airpocket-soundman/acrylic_pan_uno_q/docs/assets/hackster/acrylic-pan-12-hit-vibration-modes.gif

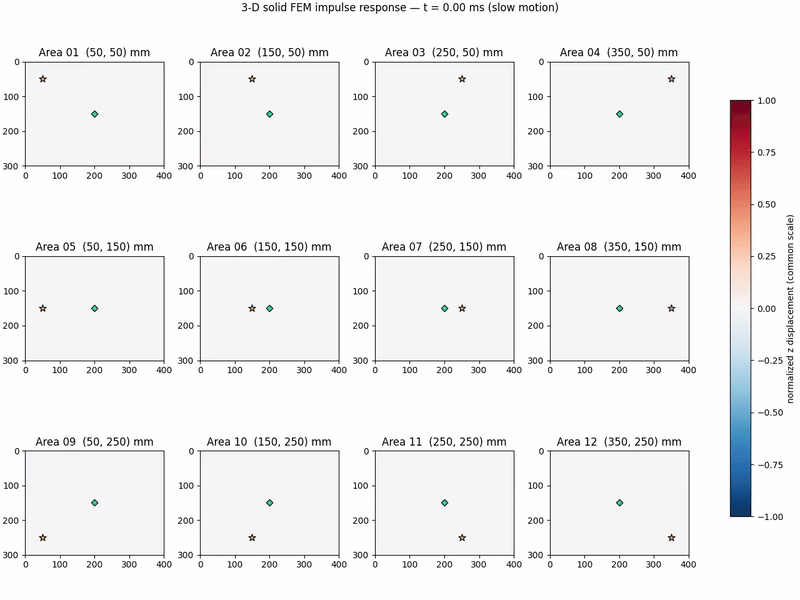
docs/assets/hackster/acrylic-pan-12-hit-vibration-modes.gif
