airpocket-soundman/acrylic_pan_uno_q/docs/assets/hackster/modal-touch-cover.png

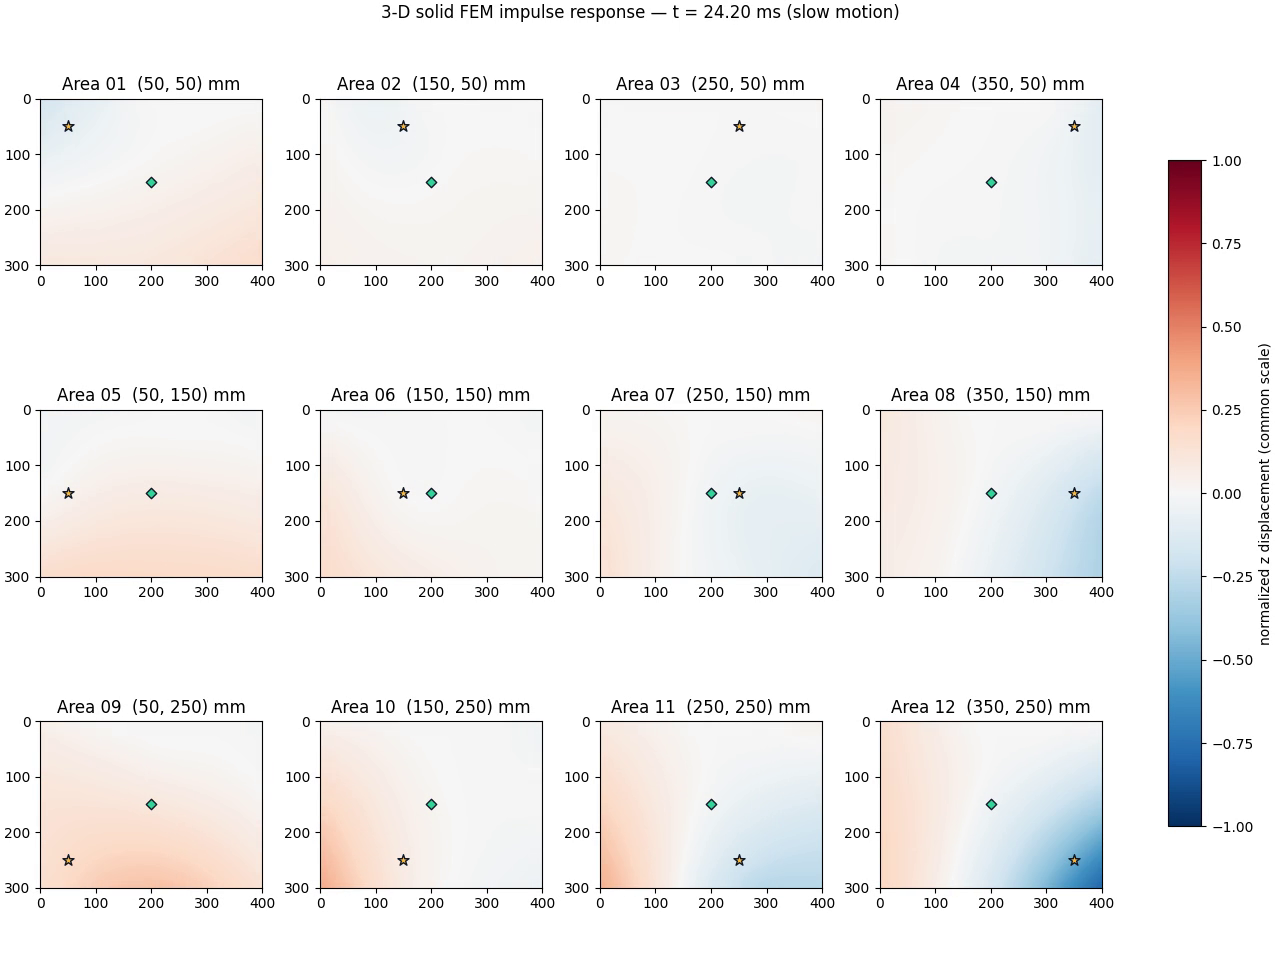
docs/assets/hackster/modal-touch-cover.png
