airpocket-soundman/acrylic_pan_uno_q/docs/assets/hackster/panel-layout.png

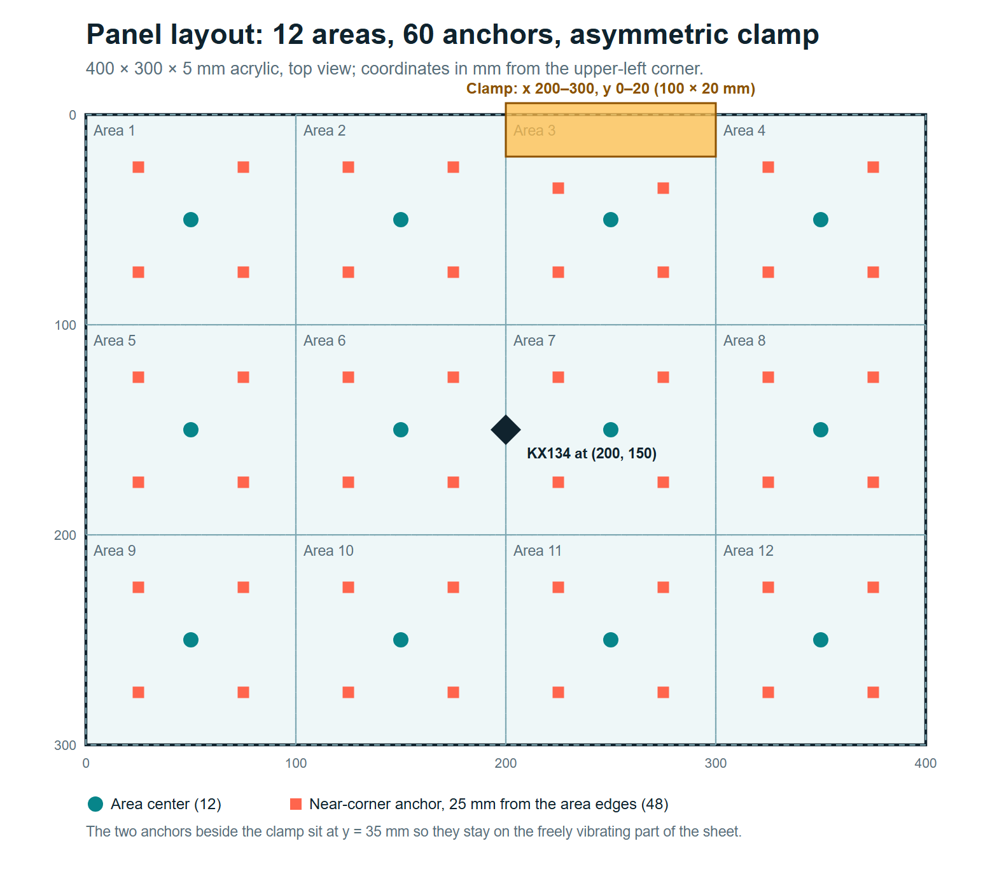
docs/assets/hackster/panel-layout.png
