airpocket-soundman/acrylic_pan_uno_q/docs/assets/hackster/pc-xy-regression-comparison.png

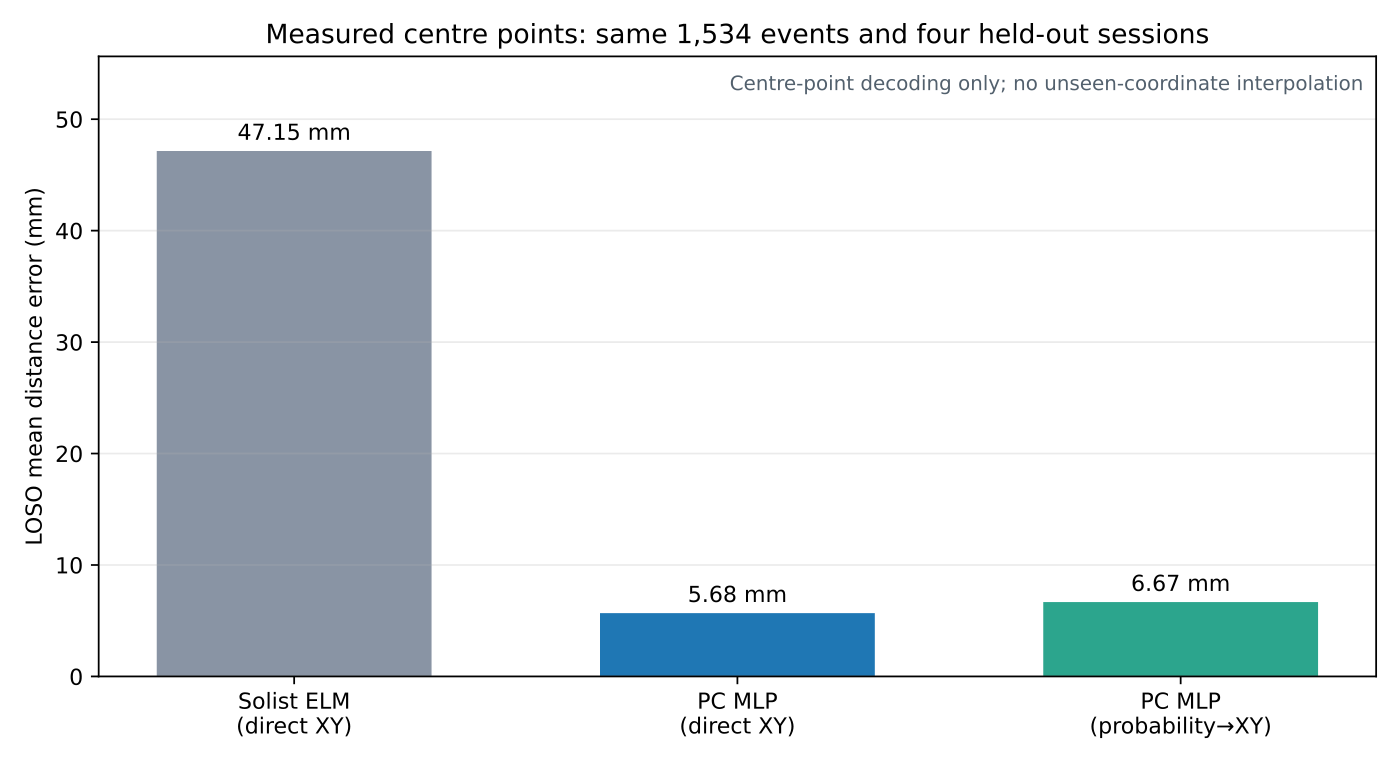
docs/assets/hackster/pc-xy-regression-comparison.png
