airpocket-soundman/acrylic_pan_uno_q/docs/assets/hackster/probability-instrument-ui.png

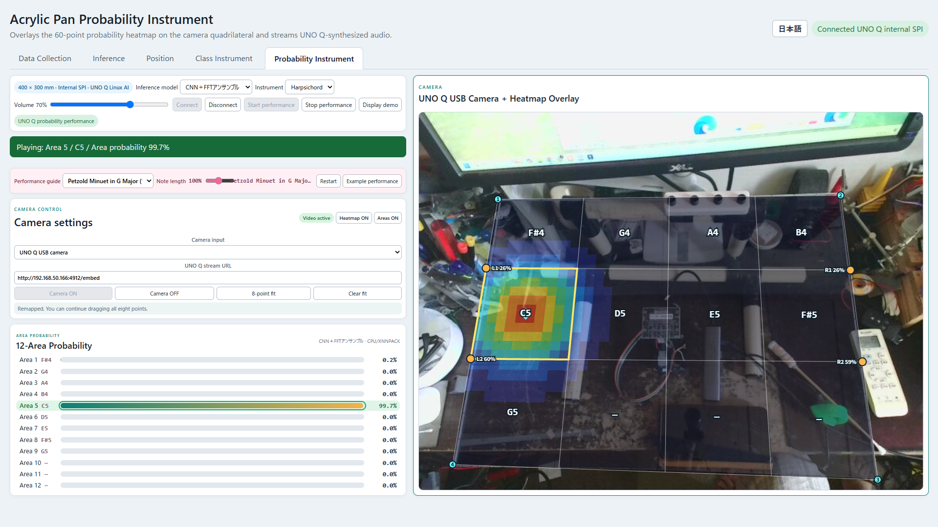
docs/assets/hackster/probability-instrument-ui.png
