airpocket-soundman/acrylic_pan_uno_q/docs/assets/hackster/uno-q-low-latency-flow.png

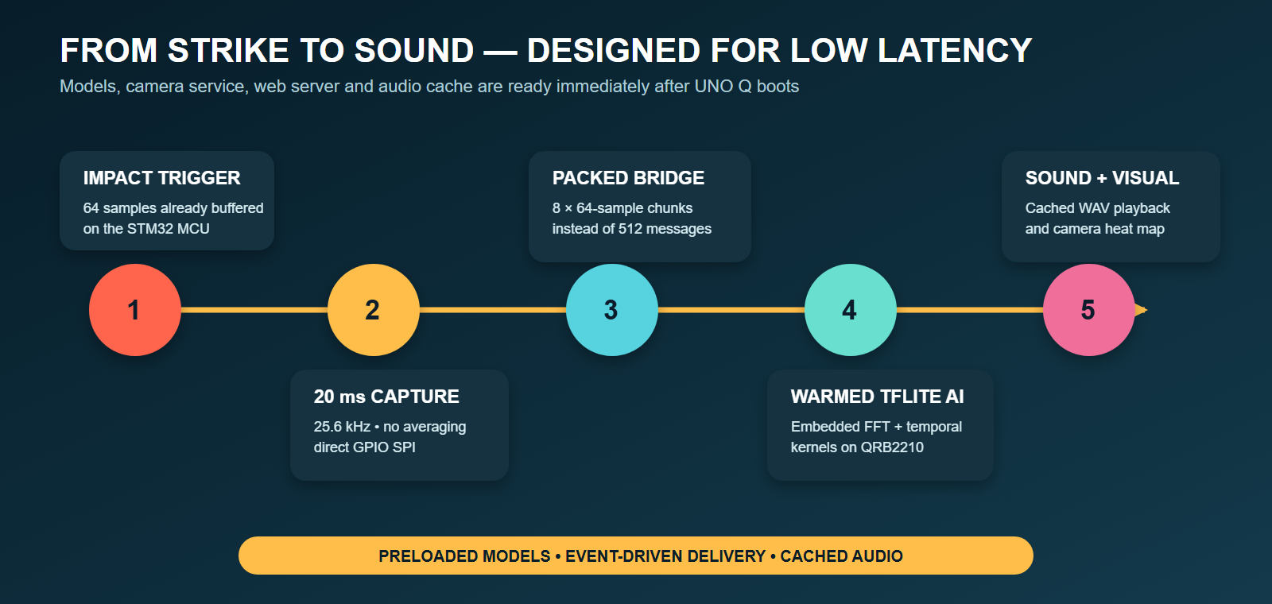
docs/assets/hackster/uno-q-low-latency-flow.png
