airpocket-soundman/acrylic_pan_uno_q/docs/assets/hackster/web/arduino-uno-q.jpg

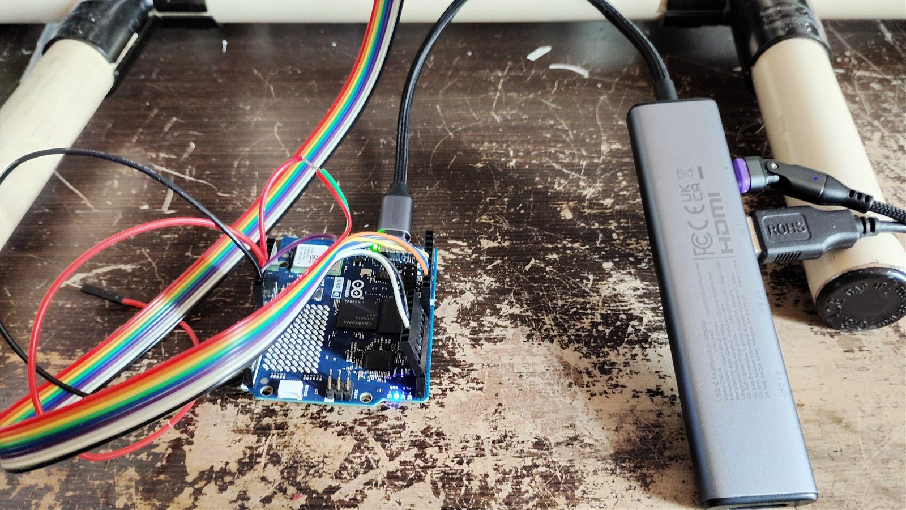
docs/assets/hackster/web/arduino-uno-q.jpg
