airpocket-soundman/acrylic_pan_uno_q/docs/assets/hackster/web/kx134-sensor-bottom.jpg

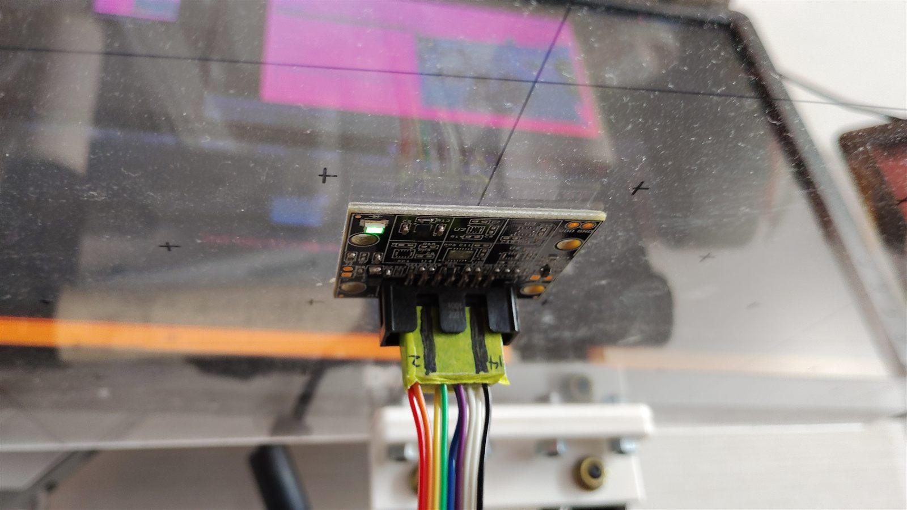
docs/assets/hackster/web/kx134-sensor-bottom.jpg
