airpocket-soundman/acrylic_pan_uno_q/docs/assets/hackster/web/kx134-sensor-top.jpg

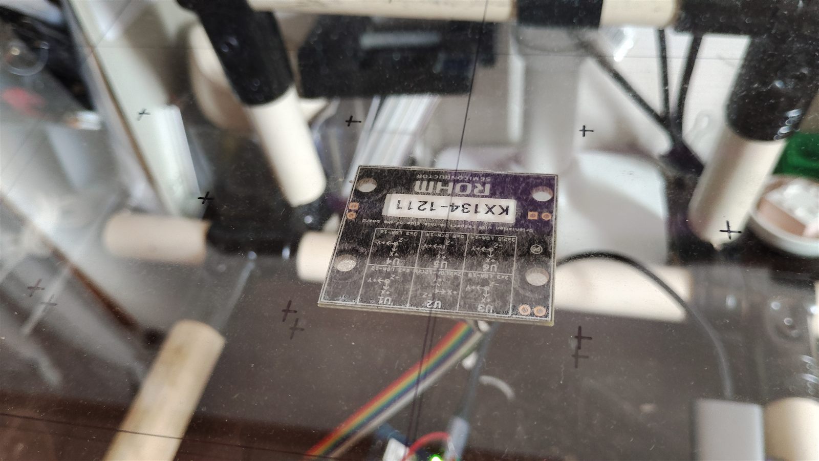
docs/assets/hackster/web/kx134-sensor-top.jpg
