airpocket-soundman/acrylic_pan_uno_q/docs/assets/hackster/web/mallet-overview.jpg

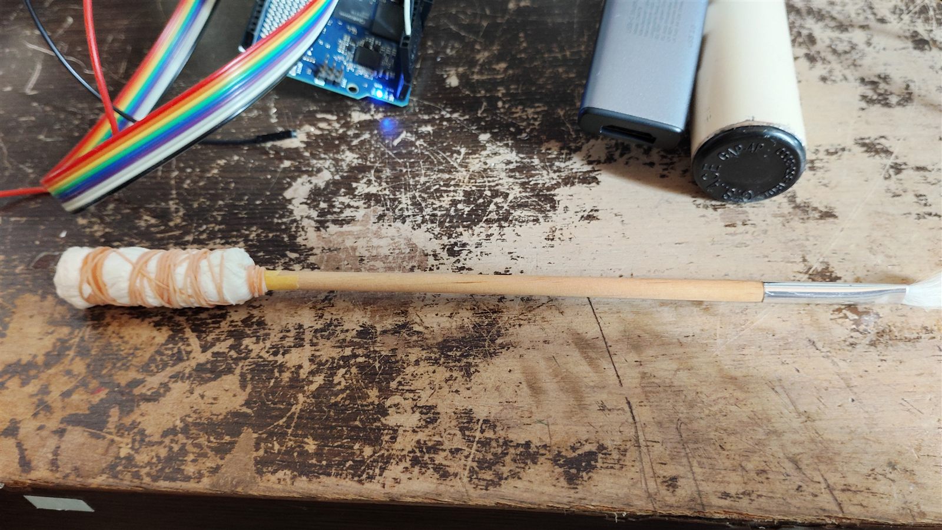
docs/assets/hackster/web/mallet-overview.jpg
