airpocket-soundman/acrylic_pan_uno_q/docs/assets/hackster/web/mallet-tip.jpg

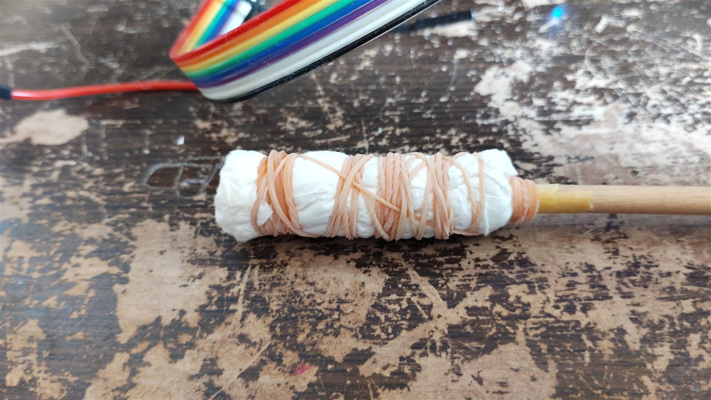
docs/assets/hackster/web/mallet-tip.jpg
