airpocket-soundman/acrylic_pan_uno_q/docs/assets/hackster/xy-training-layout.png

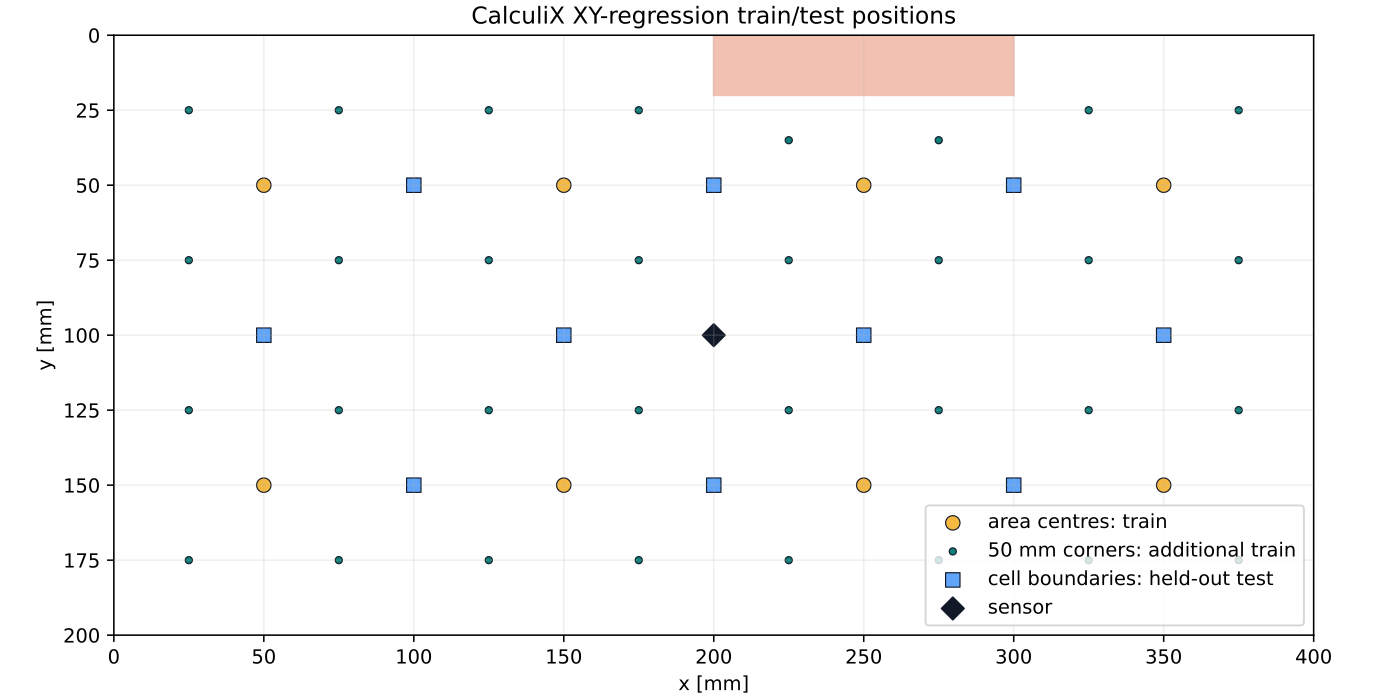
docs/assets/hackster/xy-training-layout.png
