airpocket-soundman/acrylic_pan_uno_q/docs/uno-q-bom.md

# Acrylic Pan UNO Q BOM

## 対象構成

- パネル: アクリル 400 × 300 × 5 mm
- 打点分類: 4列 × 3行、12クラス
- センサ: Solist AI用KX134-1211ブレークアウトボード × 1
- 推論・通信: Arduino UNO Q

## 本体構成品

| 区分 | 品目 | 数量 | 仕様・候補 | 状態 |
|---|---|---:|---|---|
| 演算 | Arduino UNO Q | 1 | Linux側AI・USBホスト＋MCU側SPI取得 | 使用中 |
| センサ | Solist AI用KX134-1211ブレークアウトボード | 1 | DT-EBML63Q2557キット由来の別体基板 | 既存品を流用 |
| センサケーブル | 2 × 7極 IDCメスケーブル | 1 | 2.54 mmピッチ、キー付き、既存品は約40 cm | 既存品を流用 |
| 変換コネクタ | 2 × 7極 キー付きボックスヘッダ | 1 | 参考: Würth Elektronik 61201421721、WR-BHD、ライトアングル | 調達前に嵌合・向きを実物確認 |
| 変換基板 | UNO Q–CN1 SPIアダプタ | 1 | CN1からD10–D13、D2/D3、3.3 V、GNDへ配線 | 設計・製作が必要 |
| 配線材 | ピンヘッダ／短配線 | 1式 | SPI配線は短くし、GNDを確実に共通化 | アダプタ構成に合わせて選定 |
| 打撃面 | 透明アクリル板 | 1 | 400 × 300 × 5 mm | 現行仕様 |
| センサ固定 | 硬質接着材または小型ねじ | 1式 | センサを(200, 150) mm付近へ剛結合 | 周波数応答を見て最終決定 |
| パネル固定 | クランプ／固定治具 | 1式 | FEMと実機で境界条件を一致させる | 機構設計に合わせて最終決定 |
| USBホスト | 外部給電対応USB-Cハブ | 1 | UNO Q公式カメラ構成、PD入力付き | 注文済み |
| カメラ | UVC USBカメラ | 1 | UNO Q Linux側で取得してWeb UIへ配信 | 接続試験待ち |
| ハブ電源 | 安定化5 V / 3 A電源 | 1 | USB-Cハブとカメラへの給電 | 準備が必要 |
| PC接続 | USB-Cデータケーブル | 1 | 給電・ADB・開発用。ホスト運転時はWi-Fi管理 | 使用中 |

## 開発・検査用（製品BOM外）

| 品目 | 用途 |
|---|---|
| デジタルマルチメータ | 導通、短絡、CN1-5/8の3.3 V確認 |
| ロジックアナライザまたはオシロスコープ | SPIクロック、CS、信号品質の確認（任意） |
| PC | Web UI、学習、評価、UNO Qへのデプロイ |

## 調達前の未確定事項

1. `61201421721`は形状の参照候補であり、既存IDCケーブルとのキー位置、ピン1方向、実装高さを実物で確認してから発注する。
2. 変換基板の外形、UNO Q側ヘッダ実装方式、ストレインリリーフは筐体設計後に確定する。
3. センサ固定材とパネル固定治具は、実測FRFと再現性評価の結果を部品選定へ反映する。
4. センサ基板は3.3 V専用として扱い、5 V部品や5 V信号は使用しない。

センサ接続は [`uno-q-sensor-wiring.md`](uno-q-sensor-wiring.md)、USBカメラと給電は
[`uno-q-usb-camera.md`](uno-q-usb-camera.md) を参照する。
