airpocket-soundman/acrylic_pan_uno_q/cad/bracket_b.stl

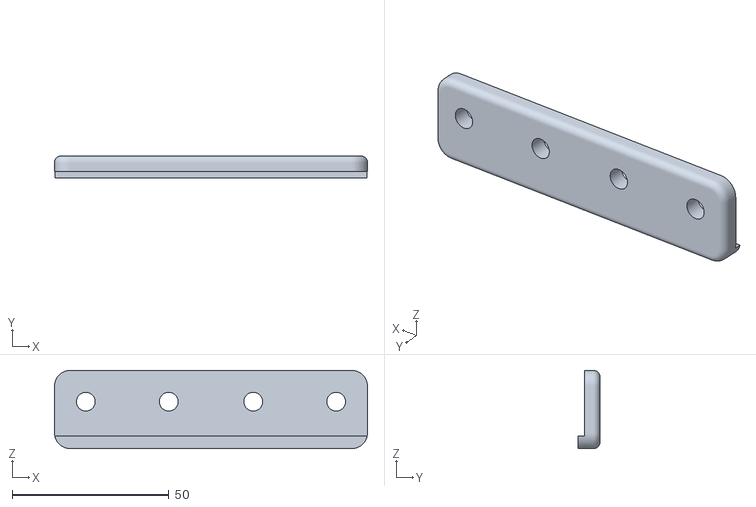
[picture p18: CAD file, 2026-09-13]
cad/bracket_b.stl
100.0 x 7.00 x 25.0
