airpocket-soundman/acrylic_pan_uno_q/cad/bracket_a.stl

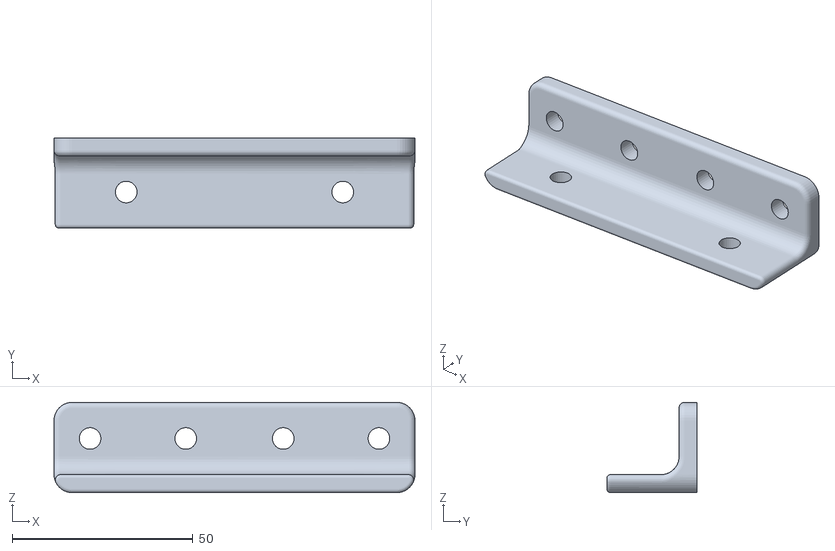
[picture p19: CAD file, 2026-09-13]
cad/bracket_a.stl
100.0 x 25.0 x 25.0
