airpocket-soundman/acrylic_pan_uno_q/docs/uno-q-sensor-wiring.md

# Solist AI用KX134ブレークアウトボード - Arduino UNO Q 配線

## 結論

DT-EBML63Q2557評価キットのSolist AI用KX134-1211ブレークアウトボードは、14ピン、2列、
2.54 mmピッチのキー付きMIL/IDCコネクタを使用する。付属40 cmケーブルを残し、
UNO Q側に2x7ボックスヘッダを持つ変換基板を追加する。

UNO Qとは3.3 VのSPIで接続する。SPI2の標準デジタルヘッダD10-D13を使用し、
将来のデータレディ割り込み用にD2とD3を予約する。

## コネクタの向き

Solist AI用KX134ブレークアウトボードを部品面から見て、KX134を上、CN1の差込口を手前にした場合:

```text
                  KX134
                    ^
                    |
       CN1（センサー基板、差込口を正面視）
       13  11   9   7   5   3   1
       14  12  10   8   6   4   2
       [========== key ==========]
```

基板シルクには右端に`1`/`2`、左端に`13`/`14`が印刷されている。
IDCケーブルの赤線または1番ピンマークをCN1-1に合わせる。変換基板側も
コネクタ部品の三角マークと赤線を1番ピンへ合わせること。キーの向きだけでなく、
導通テストでCN1-1から変換基板の1番ピンまでが直結していることを電源投入前に確認する。

IDCケーブルの**センサー側端子を嵌合面から見る**と、相手側のCN1ヘッダに対して
左右反転する。中央下の凸型キーを下にした場合は、1/2番が左端、13/14番が右端になる。

```text
       IDCケーブル（センサー側端子、嵌合面）
        1   3   5   7   9  11  13
        2   4   6   8  10  12  14
       [========== key ==========]
                    [凸]
```

## 全14ピンの割り当て

| CN1ピン | 旧CN3信号 | UNO Q接続 | STM32U585端子 | 用途 |
| ---: | --- | --- | --- | --- |
| 1 | SCL | NC | - | I2C用。SPI時は未接続 |
| 2 | GND | GND | - | GND |
| 3 | SDA | NC | - | I2C用。SPI時は未接続 |
| 4 | GND | GND | - | GND |
| 5 | Power Out | 3.3V | - | センサー電源。5V禁止 |
| 6 | INT2 | D3 | PB0 | 将来のKX134 INT2用 |
| 7 | INT1 | D2 | PB3 | 将来のKX134 INT1/DRDY用 |
| 8 | Power Out | 3.3V | - | センサーI/O電源。5V禁止 |
| 9 | MOSI | D11 / COPI | PB15 | UNO Q -> KX134 SDI |
| 10 | MISO | D12 / CIPO | PB14 | KX134 SDO -> UNO Q |
| 11 | GND | GND | - | SPIリターン |
| 12 | SCK | D13 / SCK | PB13 | SPIクロック |
| 13 | GND | GND | - | SPIリターン |
| 14 | CS | D10 / SS | PB9 | KX134 nCS |

NCの1番と3番は開放し、3.3 VやGNDへ接続しない。電源5番と8番は両方を3.3 Vへ、
GND 2/4/11/13はすべてGNDへ接続する。これはセンサーの電源系を確実に給電し、
既存フラットケーブルのSPI信号間にあるGND線を維持するためである。

## UNO Q側でこのGPIOを選んだ理由

- D10-D13はUNO QのSTM32U585に接続された標準SPI2ピンで、Arduino `SPI` APIの
  標準割り当てと一致する。
- D10はSPI2の標準SSなので、既存スケッチのCS定義をそのまま使用できる。
- D2/D3はSPIバスと競合しないSTM32U585 GPIOで、将来DRDY割り込みへ変更できる。
- センサーをLinux側MPUの1.8 V GPIOへ直結しない。リアルタイム取得は3.3 V系の
  STM32U585側で行う。
- UNO QのJSPIとデジタルヘッダSPIは同じSPI2を共有する。JSPIの2番ピンは5 Vなので、
  今回は誤給電防止のためデジタルヘッダD10-D13と独立した3.3 V端子を使用する。

## 変換アダプタ

旧DT-EBML63Q2557のCN3回路図に記載されたヘッダはWuerth Elektronik
`61201421721`（WR-BHD、2x7、2.54 mm、キー付き、ライトアングル）である。
既存ケーブルを使うアダプタには、同じキー配置の2x7オスボックスヘッダを使用する。
付属ケーブル側は2x7 IDCメスソケットである。

ブレッドボード上の長いバラ線へ14本を展開すると、25.6 kHzサンプリングのSPI信号品質を
悪化させやすい。初期確認後は、短い配線の専用変換基板またはユニバーサル基板へ固定する。

## 電源投入前チェック

1. UNO Qと旧DT-EBML63Q2557の両方からセンサーへ同時給電しない。
2. センサーをケーブルから外した状態で、変換基板CN1-5とCN1-8が3.3 Vであることを測る。
3. CN1-2/4/11/13とUNO Q GNDの導通を確認する。
4. 赤線側がCN1-1で、CN1-14がD10へ接続されていることを導通確認する。
5. センサー接続後、最初はWHO_AM_Iが`0x46`になることだけを確認する。

## 参照資料

- DT-EBML63Q2557ユーザーズマニュアル ハードウェア編 Rev.20250527:
  図2-5/2-6、図5-18、7.1コネクタピンアサイン
- Arduino UNO Q Full Pinout、2026-02-17版
- KX134-1211 Technical Reference Manual Rev.5.0
