airpocket-soundman/acrylic_pan_uno_q/docs/assets/hackster/uno-q-kx134-wiring.png

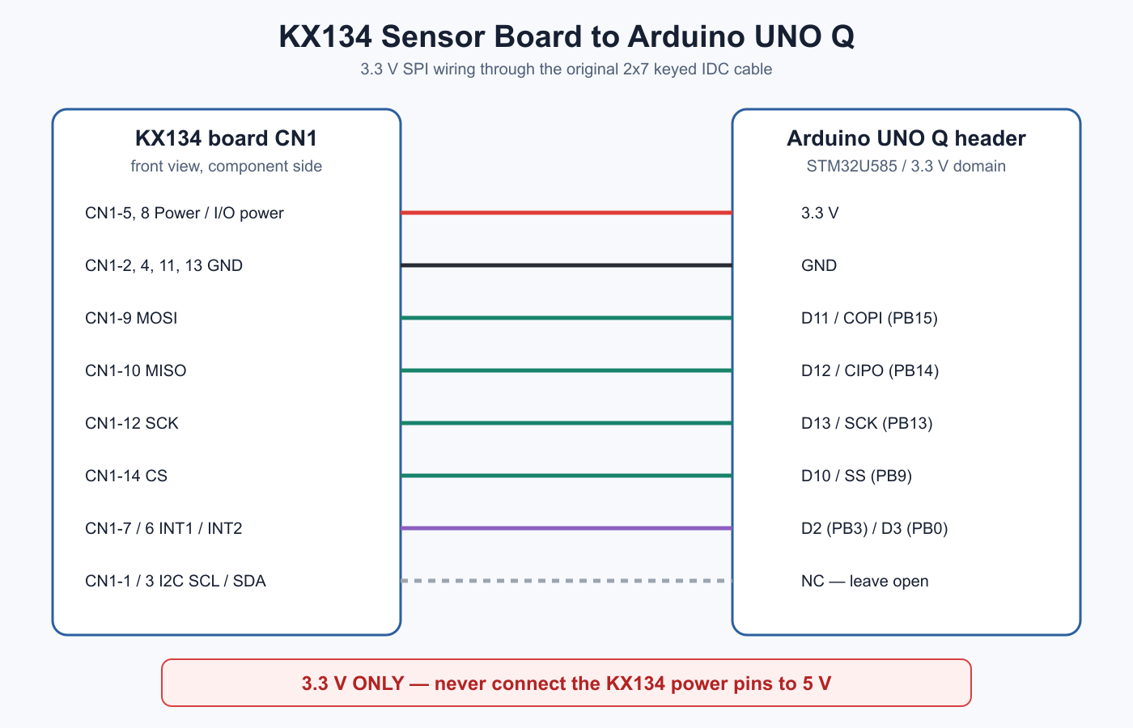
docs/assets/hackster/uno-q-kx134-wiring.png
