airpocket-soundman/acrylic_pan_uno_q/(commit log)

2026-08-21 Start Arduino UNO Q migration
2026-08-21 Document KX134 connector wiring for UNO Q
2026-08-21 docs: link BOM and sensor wiring pages
2026-09-10 docs: add KX132 UNO Q wiring diagrams
2026-09-13 cad: add 3D-printed acrylic panel brackets
    bracket_a.stl and bracket_b.stl are the printed brackets that clamp the
    acrylic sheet to the support frame.
    [bracket_a.stl, bracket_b.stl]
2026-09-13 feat: select large FFT model, SoundFont audio, and contest docs
    - Default UNO Q inference to the large embedded-FFT FP16 model evaluated
    on the all-60-position session split; retrain CPU/GPU candidates on it.
    - Render instrument notes with FluidSynth and GeneralUser GS, with the
    procedural synth as a fallback.
    - Raise the MCU re-trigger guard to 120 ms and delay the boot status report
    so a cold start reliably reaches the Linux subscribers.
    - Auto-select the UVC camera node and keep the app running across reboots.
    - Drop the trademarked song label from the performance guide.
    - Add the Hackster story preview, media plan, contest checklist, and
    third-party notices.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
    [main.py, sketch.ino]
2026-09-13 docs: add panel layout figure with anchors, clamp, and sensor
    Drawn from the 60 support coordinates used by the deployed model, the
    asymmetric clamp strip, and the sensor position.
2026-09-13 docs: explain acquisition and inference code; sync story preview
    Add comments describing the 25.6 kHz DWT-scheduled sampling loop, trigger
    and packed Bridge transfer, and the probability-map outputs. Update the
    Japanese story preview: jumper wiring instead of an adapter PCB, the panel
    layout figure, the performance guide, and a shorter inference paragraph.
    [sketch.ino]
